romioRN/DC-CDI/DC-CDI/DC-CDI/DC-CDI.jpg

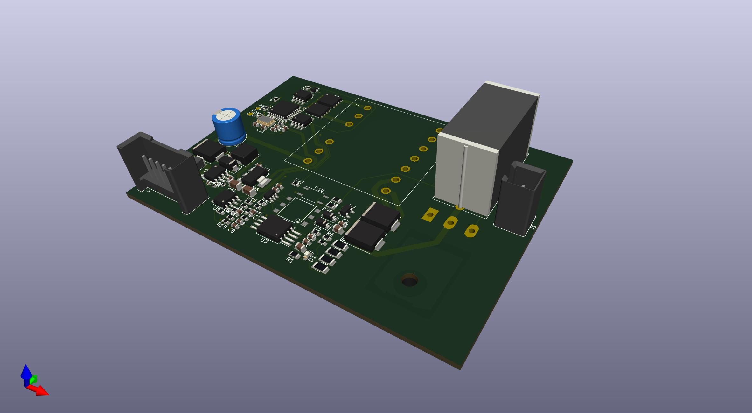
DC-CDI/DC-CDI/DC-CDI.jpg
