romioRN/DC-CDI/README.md

ВНИМАНИЕ! в плате есть отсутствующие дjрожки если вы хотите это изготовить вам нужно внести исправления
