romioRN/DC-CDI/DC-CDI/1-776280-1.step

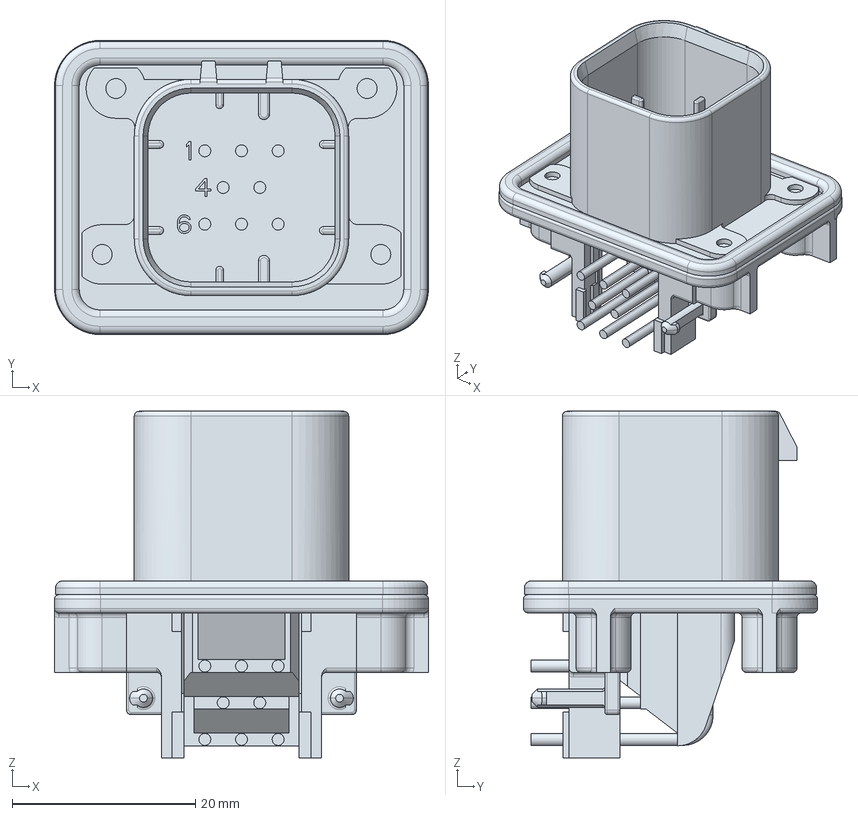
[picture p2: CAD file, 2024-10-08]
DC-CDI/1-776280-1.step
40.8 x 32.1 x 37.8 mm
