romioRN/DC-CDI/(list of files, cad)

Other CAD files:
DC-CDI/c-1-776280-1-h-3d.stp
