romioRN/DC-CDI/DC-CDI/DC-CDI/DC-CDI.kicad_pcb

## KiCad design DC-CDI/DC-CDI/DC-CDI.kicad_pcb (2024-10-09)

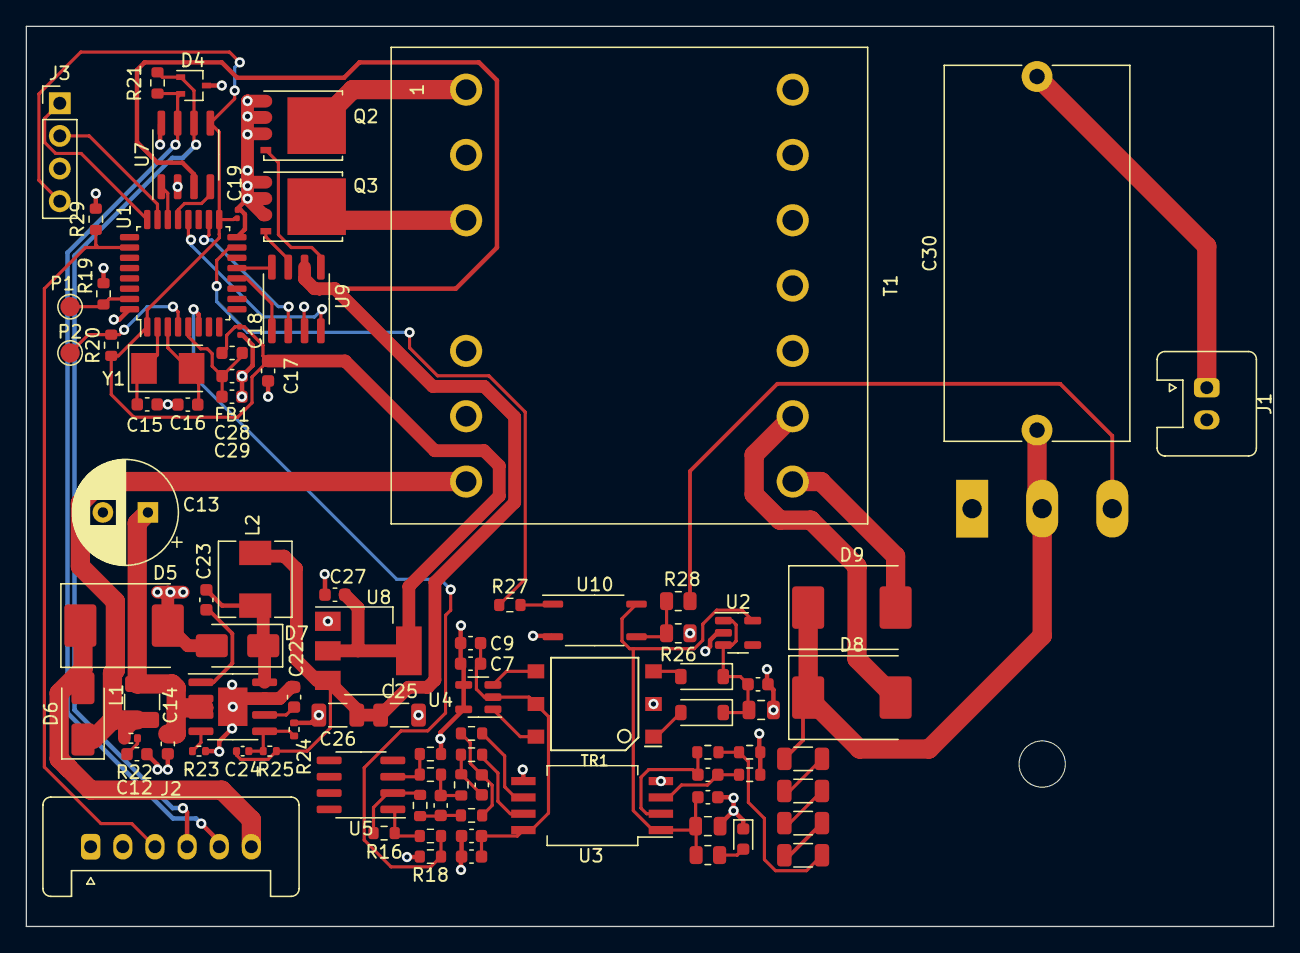
[picture p3: board DC-CDI.kicad_pcb from above]

Board: 2 copper layers, 97.0 x 70.0 mm, 90 parts (1 on the bottom side), 65 nets.

Parts:
C1, C3: 10u; C_0805_2012Metric
C2, C4, C6, C7, C23: 100n; C_0603_1608Metric
C5: 330p; C_0603_1608Metric
C8: 2.2u; C_0603_1608Metric
C9: 10u; C_0603_1608Metric
C10: 2.2n; C_0603_1608Metric
C11: 220p; C_0603_1608Metric
C12, C17, C27: 4.7u; C_0603_1608Metric
C13: 56u; CP_Radial_D8.0mm_P3.50mm
C14: 1u; C_0603_1608Metric
C15, C16: 18pF; C_0603_1608Metric
C18, C19: 100n; C_0201_0603Metric
C22: 10n; C_0603_1608Metric
C24: 330p; C_0402_1005Metric
C25, C26: 10u; C_1206_3216Metric
C28: 4.7uF; C_0603_1608Metric
C29: 100nF; C_0603_1608Metric
C30: 5u; C_Rect_L29.0mm_W14.2mm_P27.50mm_MKT
D1: POWER; LED_0603_1608Metric
D2, D3: MBR0520; D_SOD-123
D4: PESD1CAN-UX; SOT-323_SC-70
D5: SM15T33CA; D_SMC
D6, D7: D_Schottky; D_SMA
D8, D9: ES3J; D_SMC
FB1: FerriteBead; L_0603_1608Metric
J1: Conn_01x02; Stocko_MKS_1652-6-0-202_1x2_P2.50mm_Vertical
J2: Conn_01x06; Stocko_MKS_1656-6-0-606_1x6_P2.50mm_Vertical
J3: Conn_01x04; PinHeader_1x04_P2.54mm_Vertical
L1: 2.2u; L_1210_3225Metric
L2: 10u; L_Sunlord_MWSA0503S
P1, P2: Pad; TestPoint_Pad_D1.5mm
Q1: TIC106; TO-247-3_Horizontal_TabDown
Q2, Q3: BSC026N08NS5; TDSON-8-1
R1: 470; R_0805_2012Metric
R2, R3, R4, R5: 470K; R_1206_3216Metric
R6, R7, R11, R12: 1k; R_0603_1608Metric
R8: 10; R_0603_1608Metric
R9, R10: 100; R_0603_1608Metric
R13, R14: 5.6k; R_0603_1608Metric
R15, R16: 33K; R_0603_1608Metric
R17: 10k; R_0603_1608Metric
R18: 3.3k; R_0603_1608Metric
R19, R20, R27, R29: 10K; R_0603_1608Metric
R21: 120; R_0603_1608Metric
R22: 1; R_0402_1005Metric
R23: 10k; R_0402_1005Metric
R24: 12k; R_0402_1005Metric
R25: 68k; R_0402_1005Metric
R26, R28: 4.7к; R_0805_2012Metric
T1: Transformer_EPCOS_B66359A1013T_Horizontal
TR1: TRANSF5; WURTH-760390014
U1: STM32F334K8Tx; LQFP-32_7x7mm_P0.8mm
U2: TPS76350; SOT-23-5
U3: AMC1301; SSO-8_6.8x5.9mm_P1.27mm_Clearance8mm
U4: SN6501DBV; SOT-23-5
U5: OPA2197IDR; SOIC-8_3.9x4.9mm_P1.27mm
U6: LMR14020; SOIC-8-1EP_3.9x4.9mm_P1.27mm_EP2.29x3mm
U7: TJA1051T-3; SOIC-8_3.9x4.9mm_P1.27mm
U8: AMS1117-3.3; SOT-223-3_TabPin2
U9: FAN3223; SOIC-8_3.9x4.9mm_P1.27mm
U10: TLP185; SOIC-4_4.55x3.7mm_P2.54mm
Y1: 8MHz; Crystal_SMD_5032-2Pin_5.0x3.2mm

Connections:
+3.3V: C17.2, C18.2, C19.2, C27.1, FB1.2, J3.4, R20.1, U1.1 (VDD), U1.17 (VDD), U7.5 (VIO), U8.2 (VO)
+3V3: C6.1, C7.1, C8.1, C9.1, TR1.5, U3.8 (VDD2), U4.2 (VCC)
+5V: C24.1, C25.1, C26.1, L2.2, R25.2, U7.3 (VCC), U8.3 (VI), U9.6 (VDD)
+12V: D6.1 (K), L1.1, R22.1, T1.7
/12V_RAW: D5.1 (A1), D6.2 (A), J2.6
/Boot0: P1.1, R19.1, U1.31 (BOOT0)
/CANH: D4.2 (A2), J2.5, R21.1, U7.7 (CANH)
/CANL: D4.1 (A1), J2.4, R21.2, U7.6 (CANL)
/ENA: U1.12 (PA6), U9.1 (ENA)
/ENB: U1.13 (PA7), U9.8 (ENB)
/HV: R17.2, R18.1, U1.6 (PA0)
/HV_OUT: C30.1, D8.1 (K), D9.1 (K), Q1.2 (A), R2.1
/IGN_IN: J2.3, R29.1, U1.26 (PB3)
/IN_OUT: R27.1, U1.15 (PB1)
/ISO+5V: C1.1, C4.1, R1.2, U2.5 (VOUT), U3.1 (VDD1), U10.6
/RXDCAN: U1.21 (PA11), U7.4 (RXD)
/SWCLK: J3.1, U1.24 (PA14)
/SWDIO: J3.2, U1.23 (PA13)
/TXDCAN: U1.22 (PA12), U7.1 (TXD)
GND: C6.2, C7.2, C8.2, C9.2, C12.2, C13.2, C14.2, C15.2, C16.2, C17.1, C18.1, C19.1, C22.2, C25.2, C26.2, C27.2, C28.2, C29.1, D4.3 (common), D5.2 (A2), D7.2 (A), J2.1, J3.3, Q2.1 (S), Q2.2 (S), Q2.3 (S), Q3.1 (S), Q3.2 (S), Q3.3 (S), R15.2, R18.2, R19.2, R23.2, R24.2, R29.2, U1.16 (VSS), U1.32 (VSS), U3.5 (GND2), U4.4 (GND), U4.5 (GND), U6.7 (GND), U6.9 (GND), U7.2 (GND), U7.8 (S), U8.1 (GND), U9.3 (GND), U10.3
GNDA: C1.2, C2.2, C3.2, C4.2, D1.1 (K), J1.2, Q1.1 (K), R6.2, R7.2, R26.1, T1.10, T1.11, TR1.2, U2.2 (GND), U3.4 (GND2)
unnamed: C10.1, R9.1, R11.1
unnamed: C10.2, R10.1, R12.1
unnamed: C11.1, R11.2, R13.1
unnamed: C11.2, R12.2, R14.1
unnamed: C12.1, R22.2
unnamed: D1.2 (A), R1.1
unnamed: D2.2 (A), TR1.1
unnamed: C2.1, C3.1, D2.1 (K), D3.1 (K), U2.1 (VIN), U2.3 (EN)
unnamed: D3.2 (A), TR1.3
unnamed: C23.2, D7.1 (K), L2.1, U6.8 (SW)
unnamed: D8.2 (A), T1.9
unnamed: D9.2 (A), T1.8
unnamed: C30.2, J1.1
unnamed: P2.1, R20.2, U1.4 (NRST)
unnamed: Q1.3 (G), R28.1
unnamed: Q2.5 (D), T1.1
unnamed: Q2.4 (G), U9.5 (~OUTB)
unnamed: Q3.5 (D), T1.3
unnamed: Q3.4 (G), U9.7 (OUTA)
unnamed: R2.2, R3.1
unnamed: R3.2, R4.1
unnamed: R4.2, R5.1
unnamed: R5.2, R6.1, R8.1
unnamed: R16.2, R17.1, U5.1
unnamed: R26.2, R28.2, U10.4
unnamed: R27.2, U10.1
unnamed: U1.18 (PA8), U9.2 (INA)
unnamed: U1.20 (PA10), U9.4 (INB)
unnamed: C15.1, U1.2 (PF0), Y1.1
unnamed: C16.1, U1.3 (PF1), Y1.2
unnamed: C28.1, C29.2, FB1.1, U1.5 (VDDA)
unnamed: C5.2, R7.1, U3.3 (VINN)
unnamed: C5.1, R8.2, U3.2 (VINP)
unnamed: R9.2, U3.6 (VOUTN)
unnamed: R10.2, U3.7 (VOUTP)
unnamed: TR1.6, U4.1 (D1)
unnamed: TR1.4, U4.3 (D2)
unnamed: R14.2, R15.1, U5.3 (+)
unnamed: R13.2, R16.1, U5.2 (-)
unnamed: C23.1, U6.1 (BOOT)
unnamed: C13.1, C14.1, L1.2, U6.2 (VIN), U6.3 (EN)
unnamed: C24.2, R24.1, R25.1, U6.5 (FB)
unnamed: R23.1, U6.4 (RT)
unnamed: C22.1, U6.6 (SS)
