romioRN/DC-CDI/(threads)

Thread 1 (2024-11-06):

Hello is this a good way to contact you?

jharvey, 2024-11-06:
I was pointed to your CDI project from Andrey at rusEFI. I'm interested in offering to help in developing the module. Is this an good way to contact you?

I like the design, looks like a very good early draft. I like the isolation. Here are a couple suggestions.

-- R2 to R4 could be put in a straight line and could get a better hold off voltage. While this configuration could be good enough, you have space and currently the gap between R2 pad 1 to R3 pad 1 is much closer then R2 pad 1 and R2 pad 2.
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

-- Perhaps worth moving J1 up, the current will leave C30 heading to GND, if you move this connector you could shorten the potential antenna. Granted the wires connected to J1 are an antenna. However if you move the connector, that antenna will be shorter.
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

-- Perhaps worth a GND flood on the top layer. The bottom layer is good, a flood on the top layer often helps contain stray RF from getting out. As well adding stitching via's along high frequency traces helps contain RF.

-- CAN is probably reasonably high speed, Via's and similar stubs can create RF chokes. J2 traces might be better to connect from the bottom only, instead of adding additional via's. If possible, it might be good to get traces on one side of the board, to remove more stubs. It's probably not critical for CAN bus, but it helps with RF design.

-- It appears you have a JLCPCB layout. With some board we did at rusEFI years ago, we had solder mask issues, were the edge of the trace had a thin mask, which resulted in solder bridges if a via was close to a trace. We did some testing and found we wanted an additional 3 mil solder mask. The below is the setting I currently use and we have not had this issue with the solder mask being too thin sense then.
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

Again congrats on the design, I'm sure it will mostly work as it is now. I offer my suggestions hoping it makes your design better.

romioRN, 2024-11-07:
thank you so much for the ideas, I will carefully analyze and take into account everything

jharvey, 2024-11-07:
@romioRN I found a reference. Looks like the 3 mil was an OSHPark thing. See the below forum thread for additional details about this setting.
https://rusefi.com/forum/viewtopic.php?f=4&t=687&hilit=mask&start=17

In the rusEFI forums I'm kb1gtt. I've been less active lately. My kid loves baseball so I spend a lot of time brining him to games practices, etc. Active family life results in less time.

jharvey, 2024-11-07:
@romioRN Some more feedback.
-- Perhaps add some holes in the corner, would be easier to zip tie it to something if  you have some screw holes to work with.

Back when I was designing PCB's for Andrey, I created a pile of design documents. They were intended to establish a set of design goals, like what ambient temperature should it be designed for, or what kinds of electrical surging should it be able to survive. My PCB designs tried to consider ambient temperature and voltage surging. I'm not sure if I was successful in upholding the goals, but at least I had some published goals to work with. When someone would show up and say just use a 7805 instead of your complicated circuit, I'd point them to the design guides and ask them to show me it working at the elevated temperatures with the surge events happening. So far no one has shown me this working, which is my my power supply regulators are more compilated and slightly more expensive then a 7805.
https://wiki.rusefi.com/Dev-Hardware-Guidelines/#pcb-design-rules

Buried in the above rules is a Maxim design guide. Specifically I found it interesting the simulations which show how currents start to follow traces at frequencies as low as 1kHz to 50kHz range. Down around "figure 9" is extra interesting. Direct link below to make this easier to review. I suspect you'll find it interesting.
https://www.analog.com/en/resources/technical-articles/successful-pcb-grounding-with-mixedsignal-chips--follow-the-path-of-least-impedance.html

My comments about the high speed stubs for CAN is based on [hs_usb_pdg_r1_0.pdf](https://wiki.rusefi.com/PDFs/Hs_usb_pdg_r1_0_zjnjtx.pdf) They talk more about a bunch of the background with that.

Lunch is over. Keep up the good work.
